dschoorisse/videobooth-hardware/ESP32-PhotoboothHub-PCB/docs/pcb-3d-sockets-opposite.png

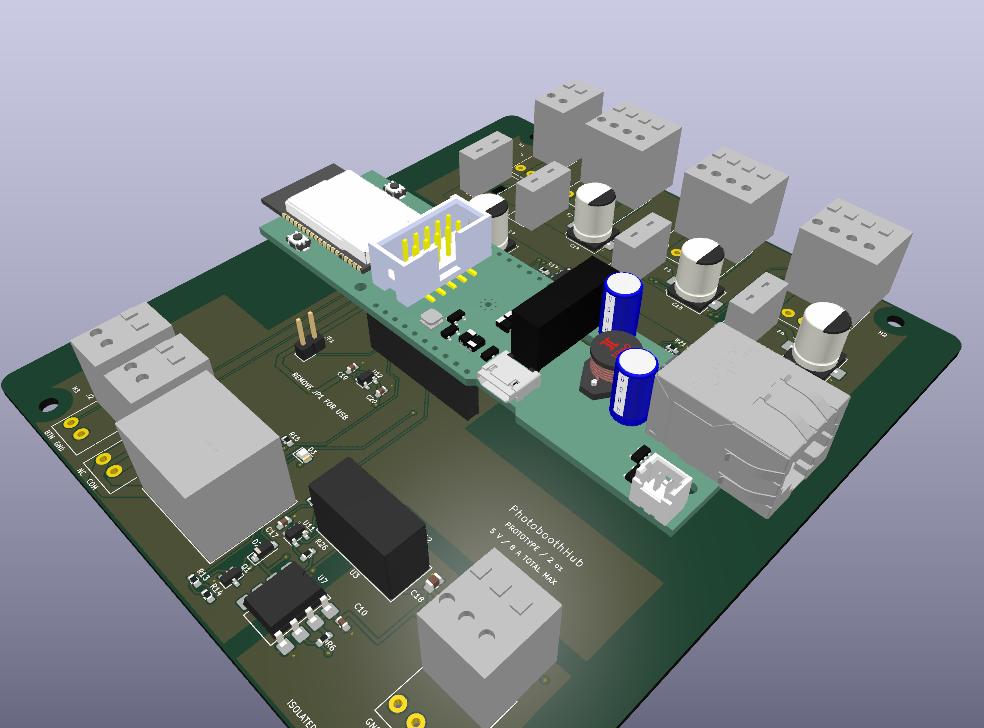
ESP32-PhotoboothHub-PCB/docs/pcb-3d-sockets-opposite.png
