dschoorisse/videobooth-hardware/ESP32-PhotoboothHub-PCB/docs/pcb-3d-sockets.png

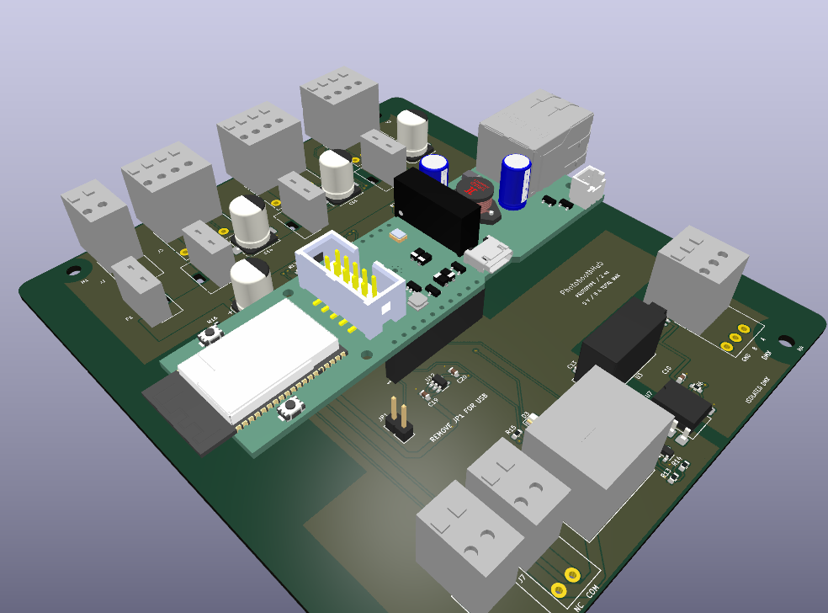
ESP32-PhotoboothHub-PCB/docs/pcb-3d-sockets.png
