dschoorisse/videobooth-hardware/ESP32-PhotoboothHub-PCB/docs/pcb-3d-top.png

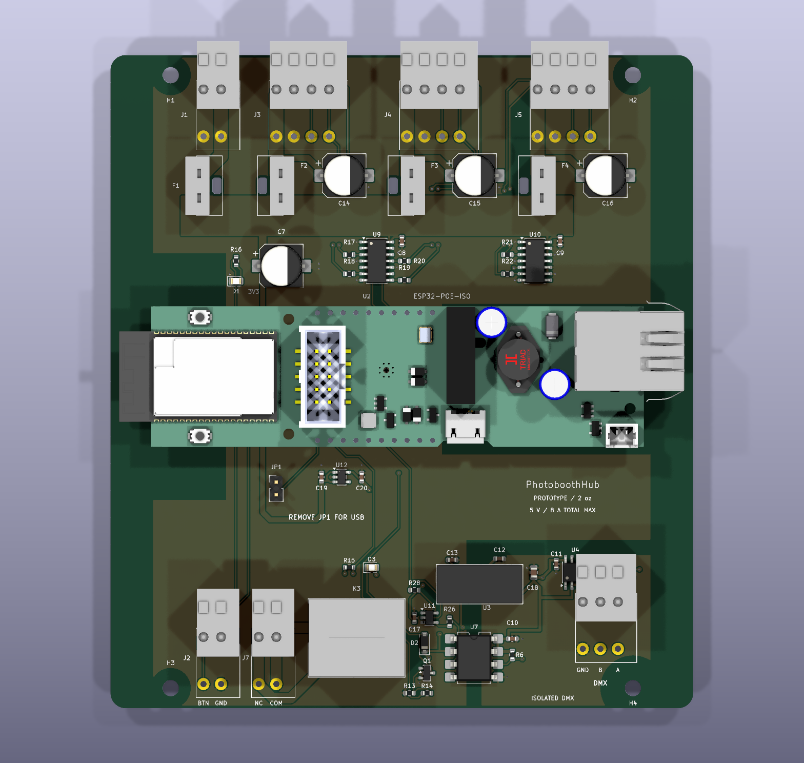
ESP32-PhotoboothHub-PCB/docs/pcb-3d-top.png
