dschoorisse/videobooth-hardware/ESP32-PhotoboothHub-PCB/docs/pcb-3d.png

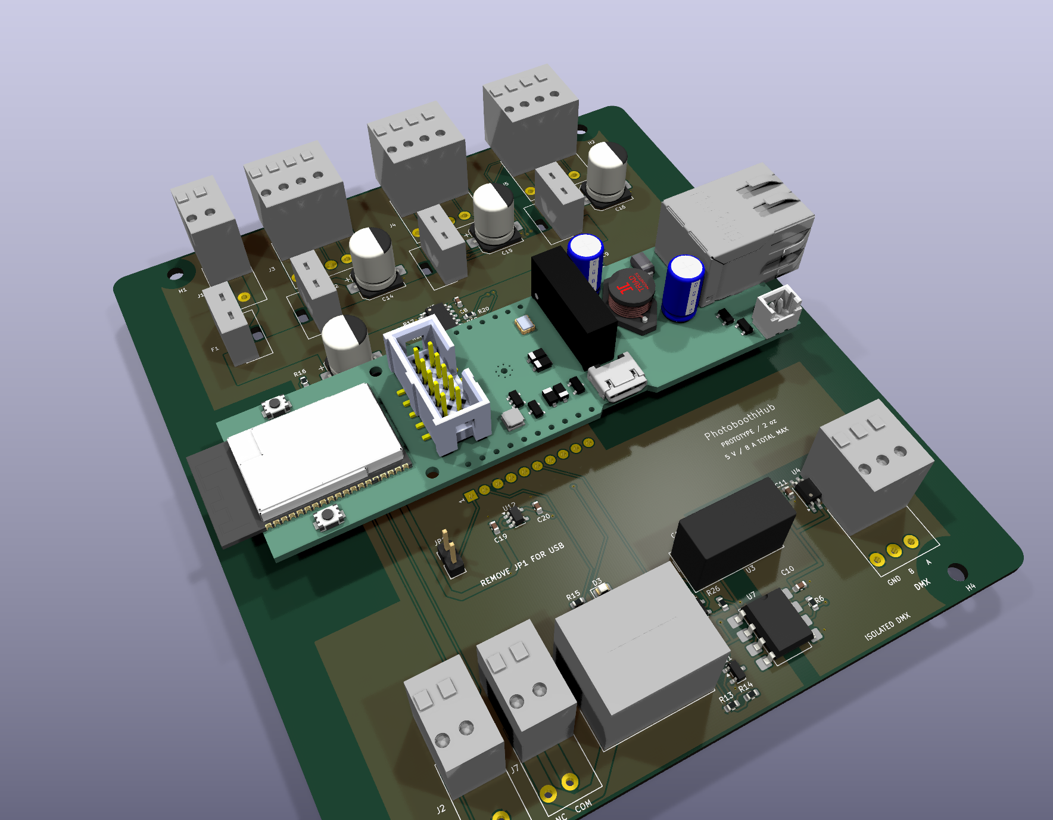
ESP32-PhotoboothHub-PCB/docs/pcb-3d.png
