dschoorisse/videobooth-hardware/ESP32-PhotoboothHub-PCB/docs/pcb-routing.png

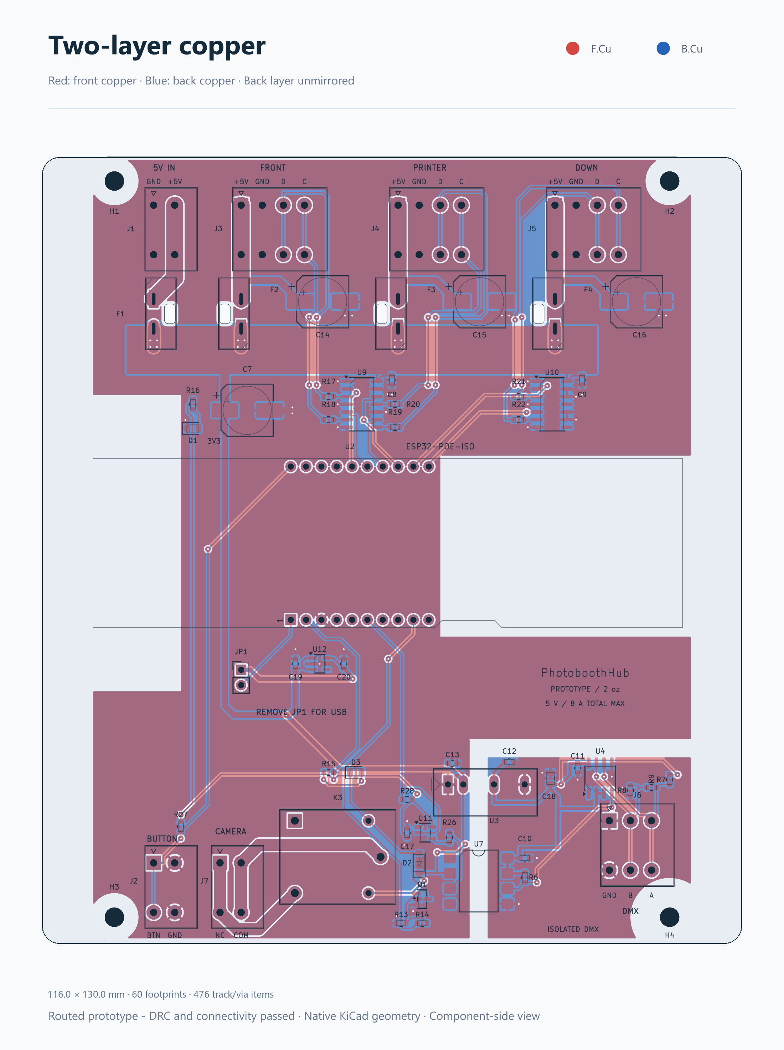
ESP32-PhotoboothHub-PCB/docs/pcb-routing.png
