dschoorisse/videobooth-hardware/(list of files, drawings)

Other design files:
_easy-eda_export/ProPrj_New Project_2025-09-22_16-04-54_2026-09-08.epro
ESP32-PhotoboothHub-PCB/docs/validation/pcb-drc.json
ESP32-PhotoboothHub-PCB/docs/validation/schematic-erc.json
