dschoorisse/videobooth-hardware/ESP32-PhotoboothHub-PCB/ProPrj_New Project_2025-09-22_16-04-54_2026-09-08.kicad_pcb

## KiCad design ESP32-PhotoboothHub-PCB/ProPrj_New Project_2025-09-22_16-04-54_2026-09-08.kicad_pcb (2026-09-14)

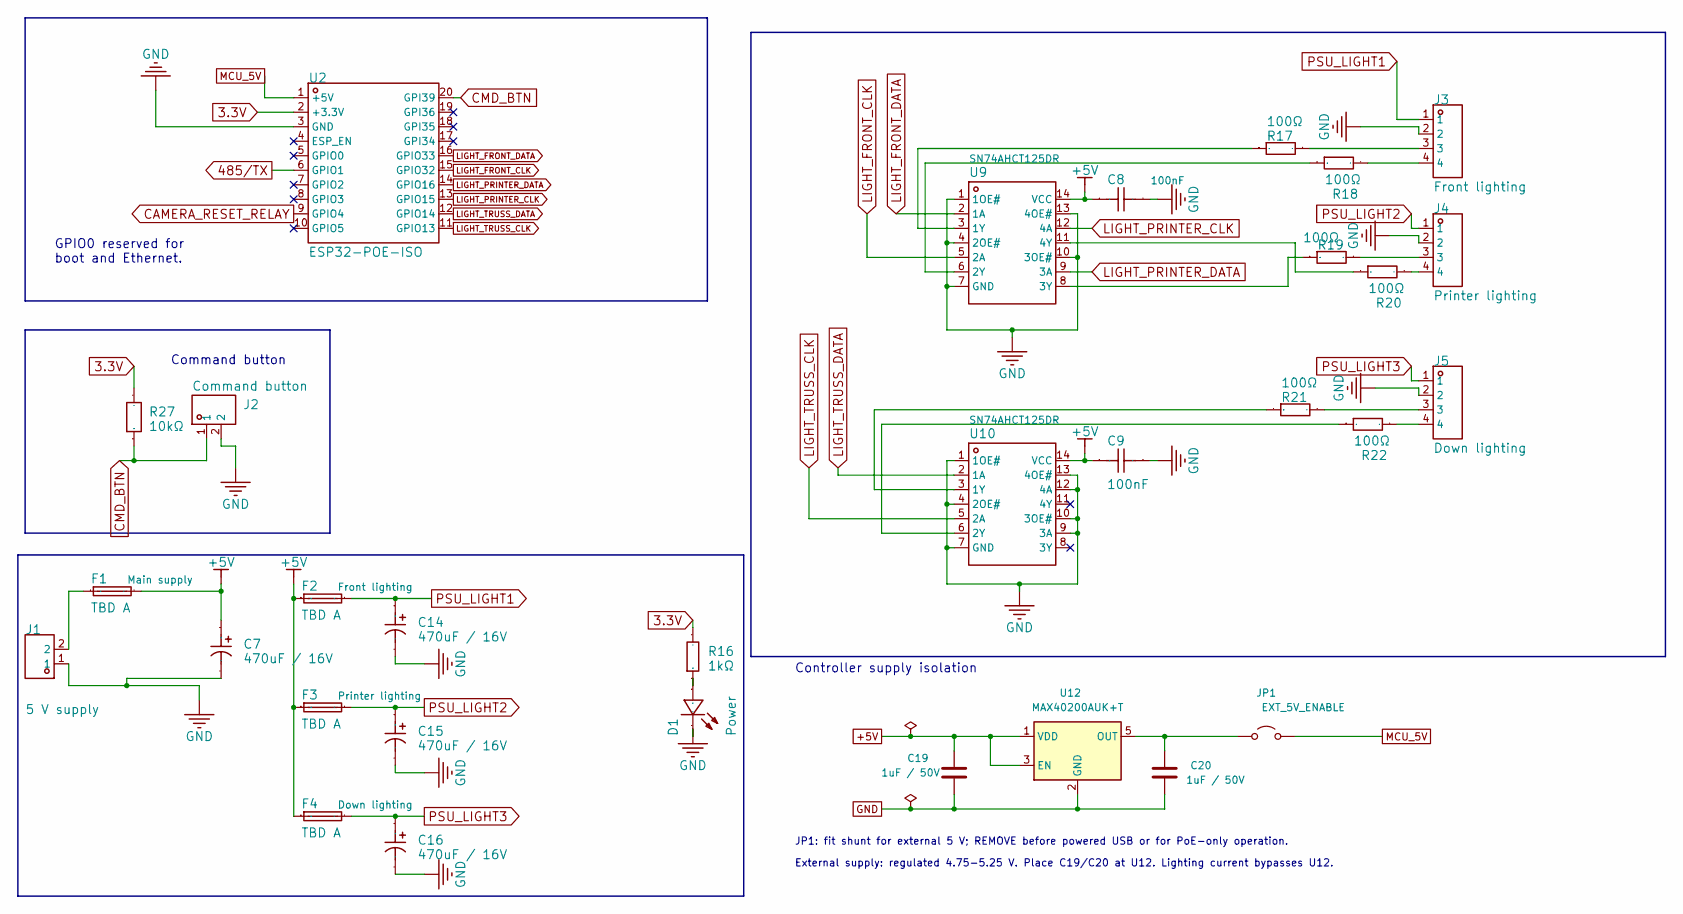
[picture p8: schematic 1_P1.kicad_sch, Photobooth Hub - Controller and lighting]

Parts:
C7, C14, C15, C16: 470uF / 16V; CP_Elec_8x10.5; Voltage Rating 16 V; Tolerance 20%; Manufacturer Part RVT1C471M0810; LCSC Part Name 470uF 16V aluminum electrolytic SMD 8x1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
C8, C9: 100nF; C_0603_1608Metric; Manufacturer Part CC0603KRX7R9BB104; LCSC Part Name 100nF ±10% 50V
C19, C20: 1uF / 50V; C_0603_1608Metric; Tolerance 10%; Voltage Rating 50 V; Manufacturer Part CL10A105KB8NNNC
D1: Power; LED_0805_2012Metric_A1K2; Manufacturer Part NCD0805R1; LCSC Part Name NCD0805R1
F1, F2, F3, F4: TBD A; Fuseholder_OptiFuse_CNT-06_MICRO2; Manufacturer Part CNT-06
J1: 5 V supply; PhoenixContact_SPT_1.5_2-V-3.5_1990850; Manufacturer Part 1990850
J2: Command button; PhoenixContact_SPT_1.5_2-V-3.5_1990850; Manufacturer Part 1990850
J3: Front lighting; PhoenixContact_SPT_1.5_4-V-3.5_1990876; Manufacturer Part 1990876
J4: Printer lighting; PhoenixContact_SPT_1.5_4-V-3.5_1990876; Manufacturer Part 1990876
J5: Down lighting; PhoenixContact_SPT_1.5_4-V-3.5_1990876; Manufacturer Part 1990876
JP1: EXT_5V_ENABLE; PinHeader_1x02_P2.54mm_Vertical; Manufacturer Part M20-9990246
R16: 1kΩ; R_0603_1608Metric; Manufacturer Part 0603WAF1001T5E; LCSC Part Name 1kΩ ±1% 100mW 厚膜电阻
R17, R18, R19, R20, R21, R22: 100Ω; R_0603_1608Metric; Manufacturer Part 0603WAF1000T5E; LCSC Part Name 100Ω ±1% 100mW 厚膜电阻
R27: 10kΩ; R_0603_1608Metric; Manufacturer Part 0603WAF1002T5E; LCSC Part Name 厚膜电阻 10kΩ ±1% 100mW
U2: ESP32-POE-ISO; Olimex_ESP32-POE-ISO; Manufacturer Part ESP32-POE-ISO; LCSC Part Name ESP32-POE-ISO
U9, U10: SN74AHCT125DR; SOIC-14_3.9x8.7mm_P1.27mm; Manufacturer Part SN74AHCT125DR; LCSC Part Name 三态输出，四路总线缓冲门
U12: MAX40200AUK+T; SOT-23-5; Manufacturer Part MAX40200AUK+T

Connections:
3.3V: R16.2, R27.2, U2.2 (+3.3V); also elsewhere on the board
485/TX: U2.6 (GPIO1); also elsewhere on the board
+5V: C7.1, C8.1, C9.1, C19.1, F1.2, F2.1, F3.1, F4.1, U9.14 (VCC), U10.14 (VCC), U12.1 (VDD), U12.3 (EN); also elsewhere on the board
CAMERA_RESET_RELAY: U2.9 (GPIO4); also elsewhere on the board
CMD_BTN: J2.1, R27.1, U2.20 (GPI39)
GND: C7.2, C8.2, C9.2, C14.2, C15.2, C16.2, C19.2, C20.2, D1.2 (-), J1.1, J2.2, J3.2, J4.2, J5.2, U2.3 (GND), U9.1 (1OE#), U9.4 (2OE#), U9.7 (GND), U9.10 (3OE#), U9.13 (4OE#), U10.1 (1OE#), U10.4 (2OE#), U10.7 (GND), U10.9 (3A), U10.10 (3OE#), U10.12 (4A), U10.13 (4OE#), U12.2 (GND); also elsewhere on the board
LIGHT_FRONT_CLK: U2.15 (GPIO32), U9.5 (2A)
LIGHT_FRONT_DATA: U2.16 (GPIO33), U9.2 (1A)
LIGHT_PRINTER_CLK: U2.13 (GPIO15), U9.12 (4A)
LIGHT_PRINTER_DATA: U2.14 (GPIO16), U9.9 (3A)
LIGHT_TRUSS_CLK: U2.11 (GPIO13), U10.5 (2A)
LIGHT_TRUSS_DATA: U2.12 (GPIO14), U10.2 (1A)
MCU_5V: JP1.2 (B), U2.1 (+5V)
unnamed: D1.1 (+), R16.1
unnamed: F1.1, J1.2
unnamed: J3.3, R17.2
unnamed: J3.4, R18.2
unnamed: J4.3, R19.2
unnamed: J4.4, R20.2
unnamed: J5.3, R21.2
unnamed: J5.4, R22.2
unnamed: C20.1, JP1.1 (A), U12.5 (OUT)
unnamed: R17.1, U9.3 (1Y)
unnamed: R18.1, U9.6 (2Y)
unnamed: R19.1, U9.8 (3Y)
unnamed: R20.1, U9.11 (4Y)
unnamed: R21.1, U10.3 (1Y)
unnamed: R22.1, U10.6 (2Y)
PSU_LIGHT1: C14.1, F2.2, J3.1
PSU_LIGHT2: C15.1, F3.2, J4.1
PSU_LIGHT3: C16.1, F4.2, J5.1

Notes on the sheet:
External supply: regulated 4.75-5.25 V. Place C19/C20 at U12. Lighting current bypasses U12.
JP1: fit shunt for external 5 V; REMOVE before powered USB or for PoE-only operation.
Command button
GPIO0 reserved for boot and Ethernet.
Controller supply isolation

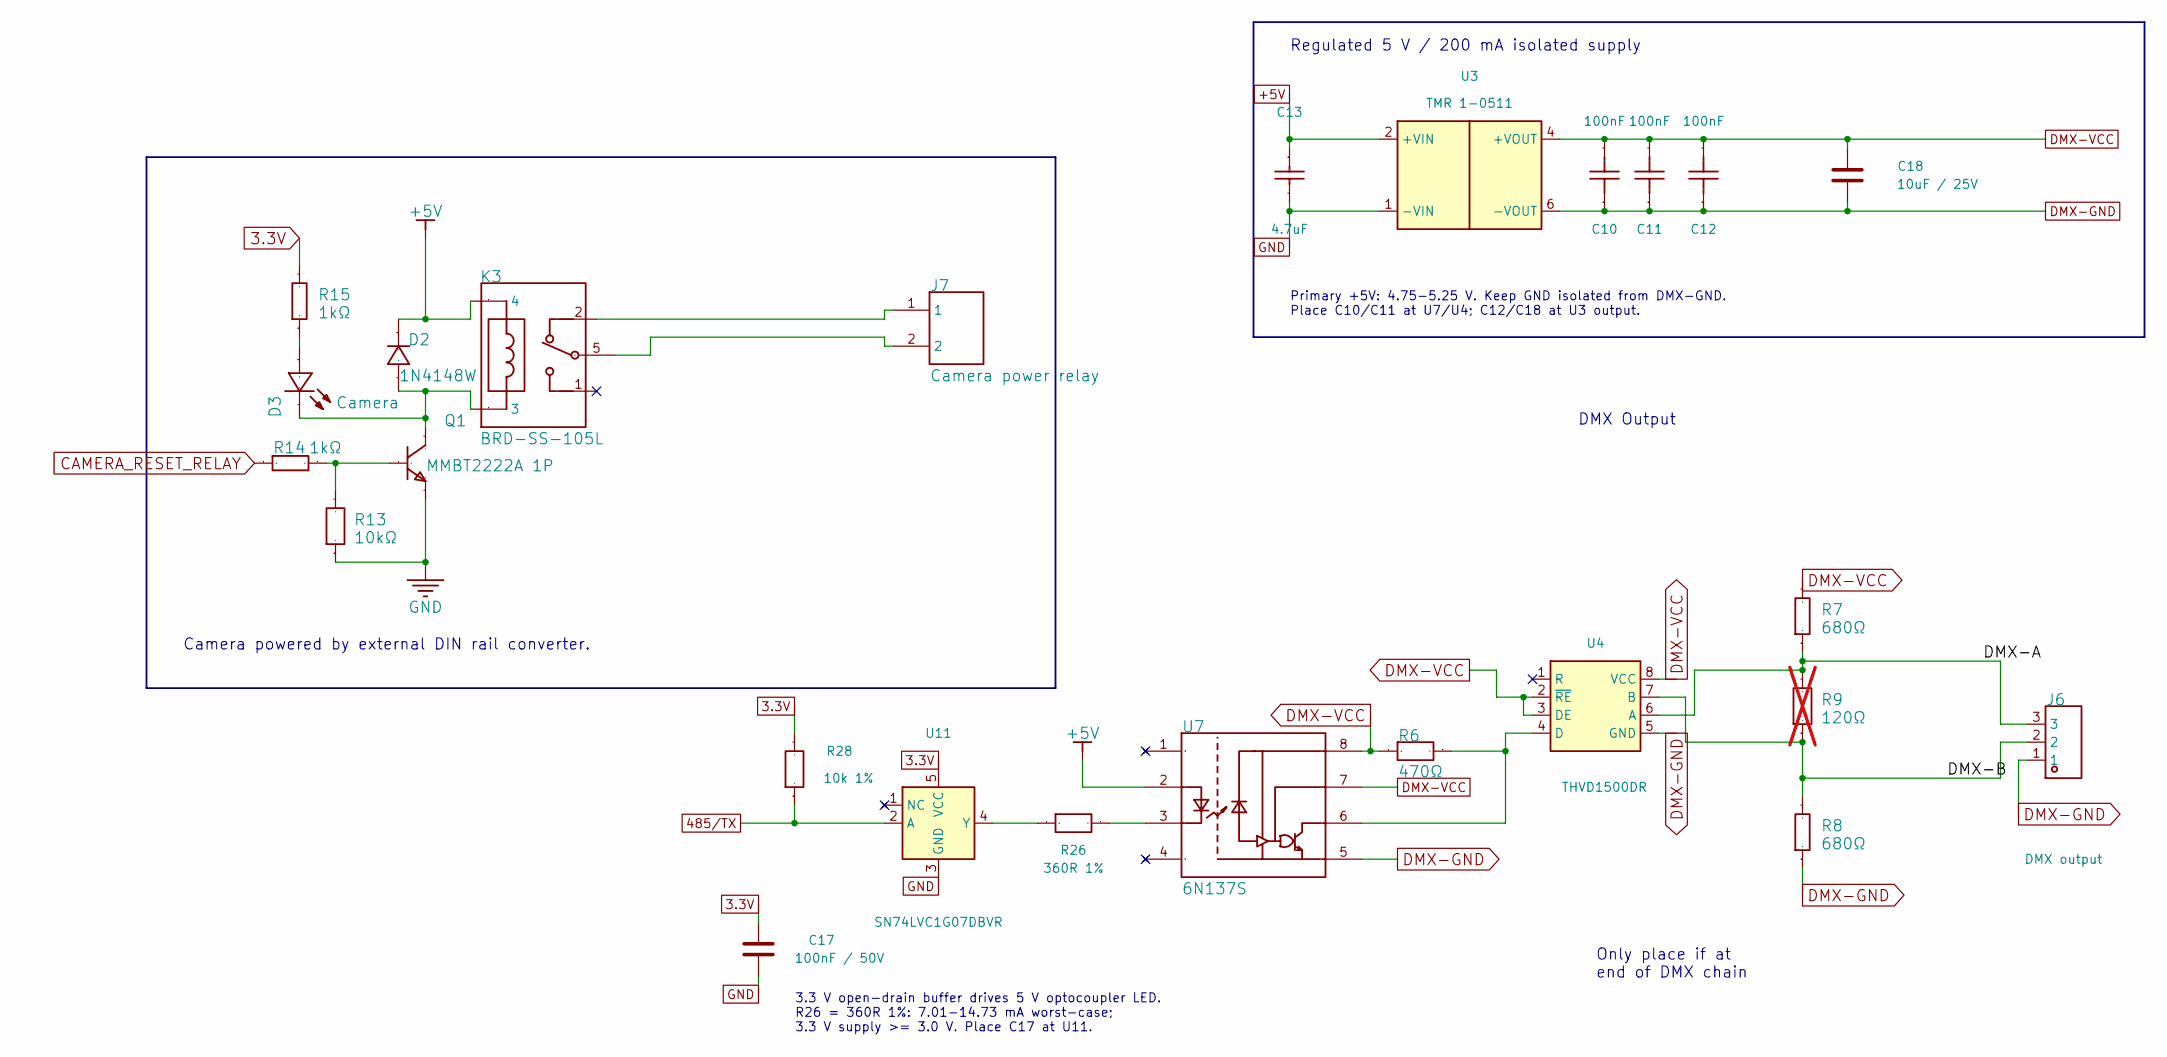
[picture p9: schematic 2_P2.kicad_sch, Photobooth Hub - Isolated DMX and camera reset]

Parts:
C10, C11, C12: 100nF; C_0603_1608Metric; Manufacturer Part CC0603KRX7R9BB104; LCSC Part Name 100nF ±10% 50V
C13: 4.7uF; C_0603_1608Metric; Manufacturer Part CL10A475KO8NNNC; LCSC Part Name 4.7uF ±10% 16V
C17: 100nF / 50V; C_0603_1608Metric; Voltage Rating 50 V; Manufacturer Part CC0603KRX7R9BB104
C18: 10uF / 25V; C_0805_2012Metric; Voltage Rating 25 V; Manufacturer Part CL21A106KAYNNNE
D2: 1N4148W; D_SOD-123; Manufacturer Part 1N4148W; LCSC Part Name 1N4148W
D3: Camera; LED_0805_2012Metric_A1K2; Manufacturer Part NCD0805R1; LCSC Part Name NCD0805R1
J6: DMX output; PhoenixContact_SPT_1.5_3-V-3.5_1990863; Manufacturer Part 1990863
J7: Camera power relay; PhoenixContact_SPT_1.5_2-V-3.5_1990850; Manufacturer Part 1990850
K3: BRD-SS-105L; Relay_SPDT_QLRELAY_BRD-SS-105L; Manufacturer Part BRD-SS-105L; LCSC Part Name 功率继电器
Q1: MMBT2222A 1P; SOT-23; Manufacturer Part MMBT2222A 1P; LCSC Part Name hFE：100-300 丝印1P
R6: 470Ω; R_0603_1608Metric; Manufacturer Part 0603WAF4700T5E; LCSC Part Name 470Ω ±1% 100mW 厚膜电阻
R7, R8: 680Ω; R_0603_1608Metric; Manufacturer Part 0603WAF6800T5E; LCSC Part Name 680Ω ±1% 100mW 厚膜电阻
R9: 120Ω; R_0603_1608Metric; Manufacturer Part 0603WAF1200T5E; LCSC Part Name 120Ω ±1% 100mW 厚膜电阻; not fitted
R13: 10kΩ; R_0603_1608Metric; Manufacturer Part 0603WAF1002T5E; LCSC Part Name 厚膜电阻 10kΩ ±1% 100mW
R14, R15: 1kΩ; R_0603_1608Metric; Manufacturer Part 0603WAF1001T5E; LCSC Part Name 1kΩ ±1% 100mW 厚膜电阻
R26: 360R 1%; R_0603_1608Metric; Tolerance 1%; Manufacturer Part 0603WAF3600T5E
R28: 10k 1%; R_0603_1608Metric; Tolerance 1%; Manufacturer Part 0603WAF1002T5E
U3: TMR 1-0511; Converter_DCDC_TRACO_TMR-1-xxxx_Single_THT; Manufacturer Part TMR 1-0511
U4: THVD1500DR; SOIC-8_3.9x4.9mm_P1.27mm; Manufacturer Part THVD1500DR
U7: 6N137S; SMDIP-8_W9.53mm; Manufacturer Part 6N137S; LCSC Part Name 光耦
U11: SN74LVC1G07DBVR; SOT-23-5; Manufacturer Part SN74LVC1G07DBVR

Connections:
3.3V: C17.1, R15.2, R28.2, U11.5 (VCC); also elsewhere on the board
485/TX: R28.1, U11.2 (A); also elsewhere on the board
+5V: C13.1, D2.1 (C), K3.4, U3.2 (+VIN), U7.2 (A); also elsewhere on the board
/P2/DMX-A: J6.3, R7.1, R9.2, U4.6 (A)
/P2/DMX-B: J6.2, R8.2, R9.1, U4.7 (B)
CAMERA_RESET_RELAY: R14.1; also elsewhere on the board
DMX-GND: C10.1, C11.1, C12.1, C18.2, J6.1, R8.1, U3.6 (-VOUT), U4.5 (GND), U7.5 (GND)
DMX-VCC: C10.2, C11.2, C12.2, C18.1, R6.1, R7.2, U3.4 (+VOUT), U4.2 (~RE), U4.3 (DE), U4.8 (VCC), U7.7 (VE), U7.8 (VCC)
GND: C13.2, C17.2, Q1.2 (E), R13.1, U3.1 (-VIN), U11.3 (GND); also elsewhere on the board
unnamed: D2.2 (A), D3.2 (-), K3.3, Q1.3 (C)
unnamed: D3.1 (+), R15.1
unnamed: J7.1, K3.2
unnamed: J7.2, K3.5
unnamed: Q1.1 (B), R13.2, R14.2
unnamed: R6.2, U4.4 (D), U7.6 (VO)
unnamed: R26.2, U7.3 (C)
unnamed: R26.1, U11.4 (Y)

Notes on the sheet:
DMX Output
Primary +5V: 4.75-5.25 V. Keep GND isolated from DMX-GND. Place C10/C11 at U7/U4; C12/C18 at U3 output.
Only place if at end of DMX chain
Regulated 5 V / 200 mA isolated supply
Camera powered by external DIN rail converter.
3.3 V open-drain buffer drives 5 V optocoupler LED. R26 = 360R 1%: 7.01-14.73 mA worst-case; 3.3 V supply >= 3.0 V. Place C17 at U11.

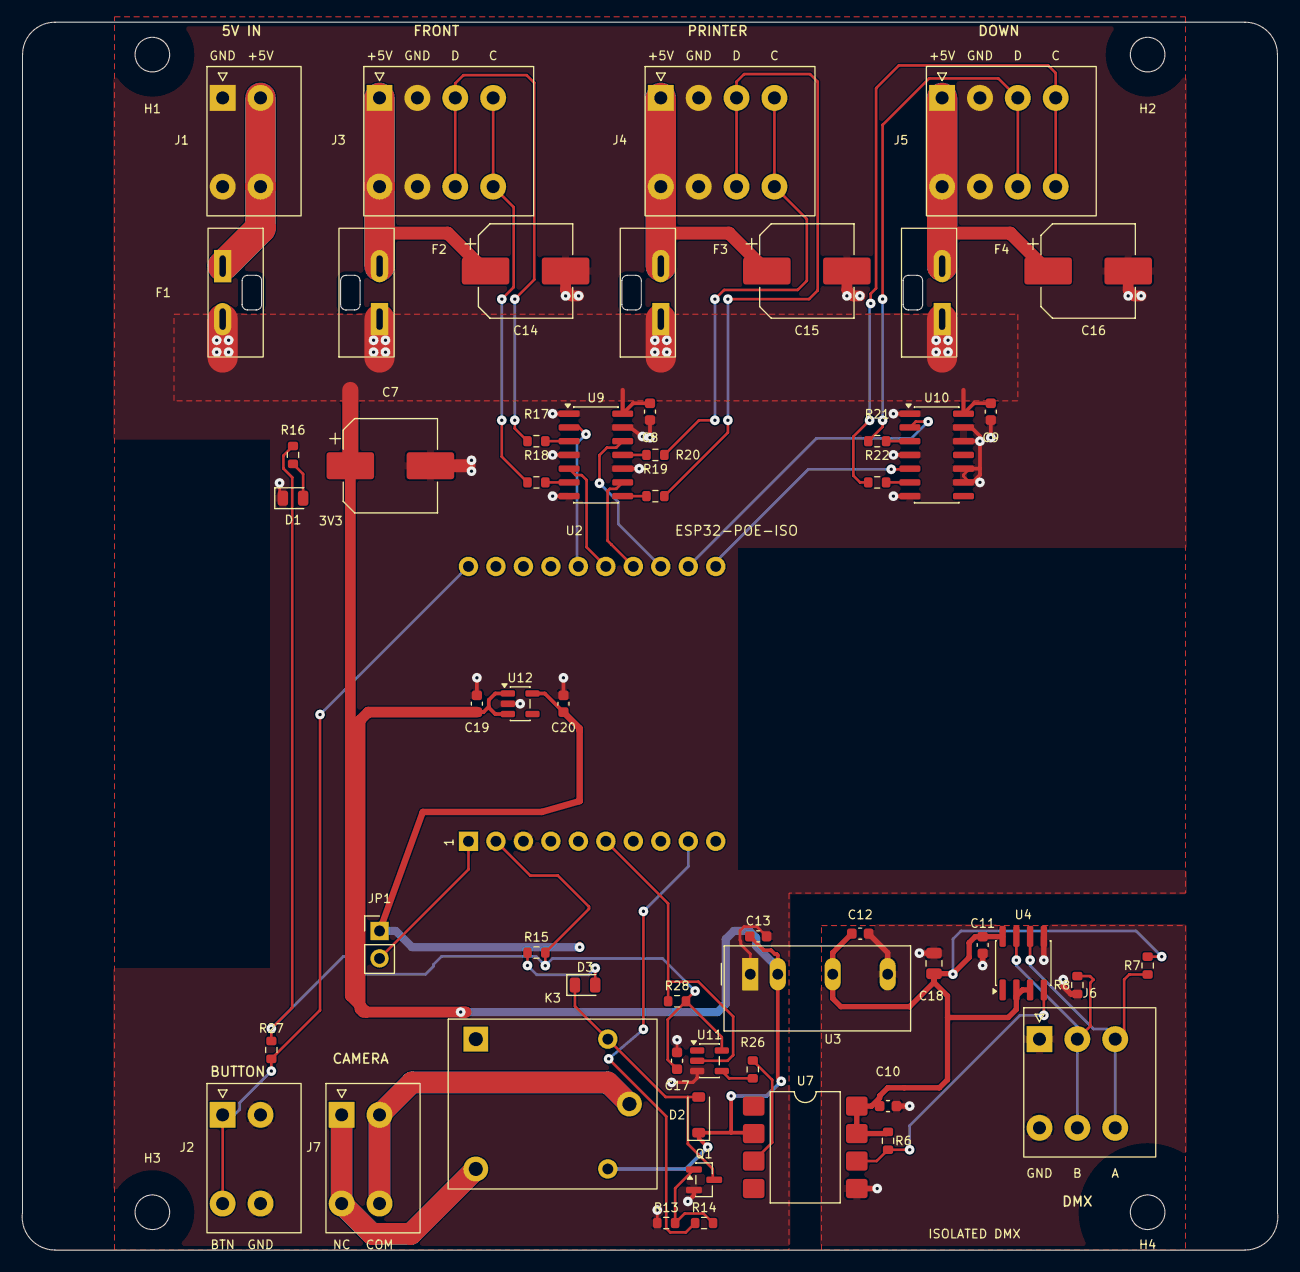
[picture p10: board ProPrj_New Project_2025-09-22_16-04-54_2026-09-08.kicad_pcb from above]

Board: 2 copper layers, 116.1 x 113.5 mm, 59 parts (0 on the bottom side), 43 nets.

Other parts of the board:
H1, H2, H3, H4: M3 carrier mounting; MountingHole_3.2mm_M3
