dschoorisse/videobooth-hardware/(commit log)

2025-05-27 combine printer lights with internal LED lights for lighting of the subject
2025-05-27 remove the separate printer light
2025-09-09 Rename ESP32-Lights to ESP32-PhotoboothHub and add hardware shutdown button
    - Renamed directory from ESP32-Lights to ESP32-PhotoboothHub to reflect expanded functionality
    - Renamed Lights.yaml to PhotoboothHub.yaml for consistency
    - Added physical shutdown button on GPIO21 with 5-second hold logic
    - Integrated MQTT shutdown command publishing to lights/shutdown/command topic
    - Updated README.md with comprehensive documentation including hardware setup, features, and future DMX integration plans
    - Maintained all existing LED control functionality for printer status and front lighting
2025-10-20 Enhance PhotoboothHub configuration with DMX support, multiple SPI buses, and improved shutdown button functionality
2026-08-15 do not switch off lights when reconnecting
2026-09-08 Add initial KiCad PCB project baseline
2026-09-08 Add imported EasyEDA schematic baseline
2026-09-08 Fix photobooth schematic power, DMX and component footprints
2026-09-08 Add PCB placement with Ethernet on the right
2026-09-13 Complete PCB routing with protected power bus and verified isolation
2026-09-14 Update PCB design and 3D assets
2026-09-14 Update photobooth PCB and validation assets
2026-09-14 Update photobooth schematic and PCB layout
